LassiHeikkila/imu-mouse-hw/imu-mouse-3d-2.png

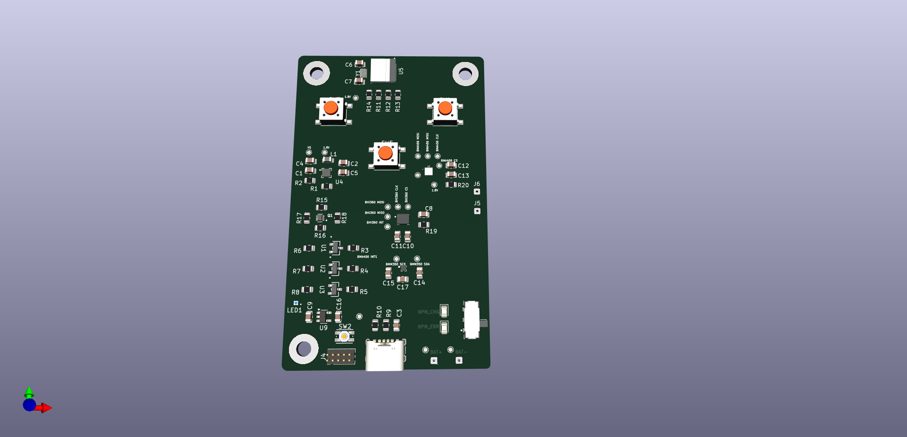
imu-mouse-3d-2.png
