LassiHeikkila/imu-mouse-hw/imu-mouse-3d-1.png

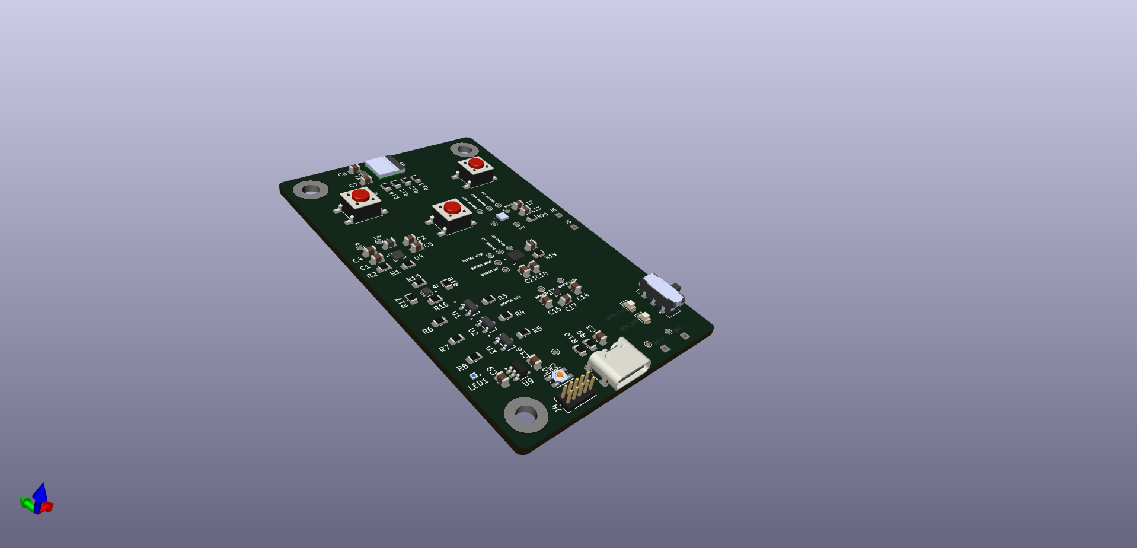
imu-mouse-3d-1.png
