LassiHeikkila/imu-mouse-hw/symbols/ANNA_B112_70B/ANNA-B112--3DModel-STEP-56544.STEP

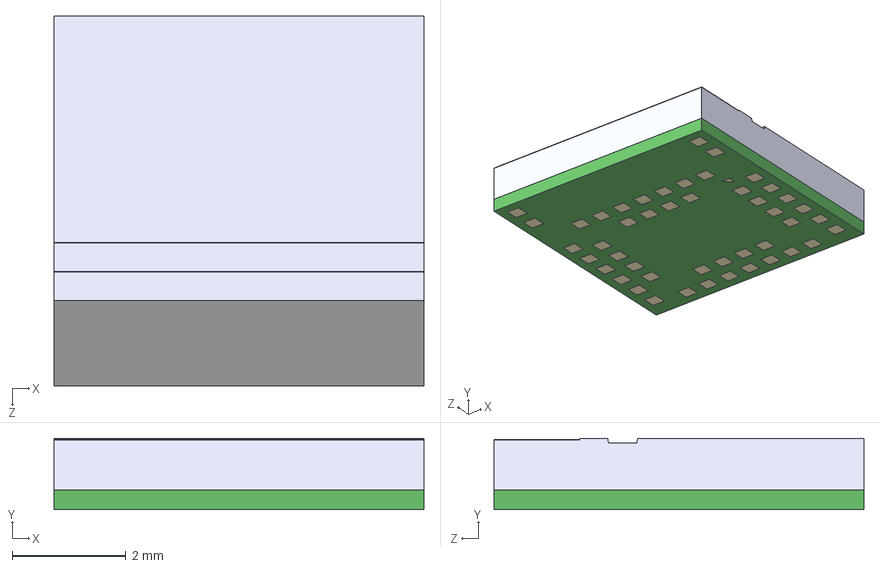
[picture p3: CAD file, 2024-06-25]
symbols/ANNA_B112_70B/ANNA-B112--3DModel-STEP-56544.STEP
6.50 x 1.25 x 6.50 mm
