LassiHeikkila/imu-mouse-hw/symbols/BHI360/LGA20_2p5X3X0p95_BOS.step

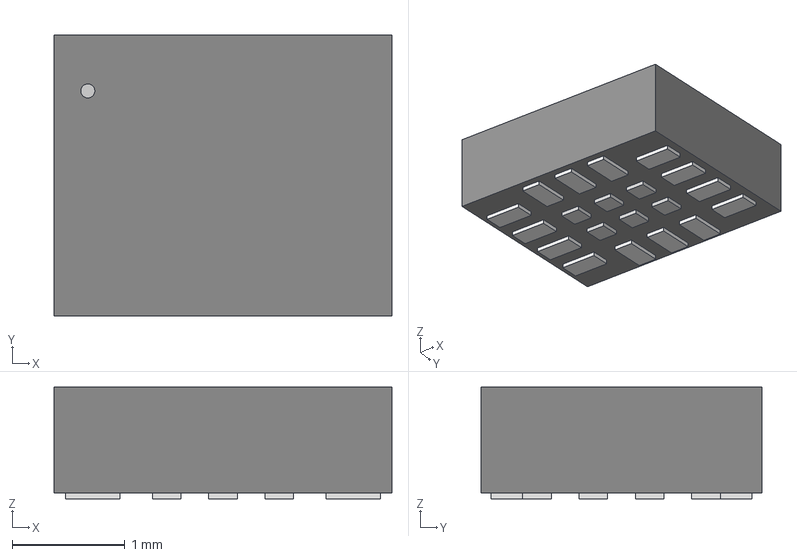
[picture p4: CAD file, 2024-06-25]
symbols/BHI360/LGA20_2p5X3X0p95_BOS.step
3.00 x 2.49 x 0.993 mm
