LassiHeikkila/imu-mouse-hw/symbols/BMA456/BMA456.step

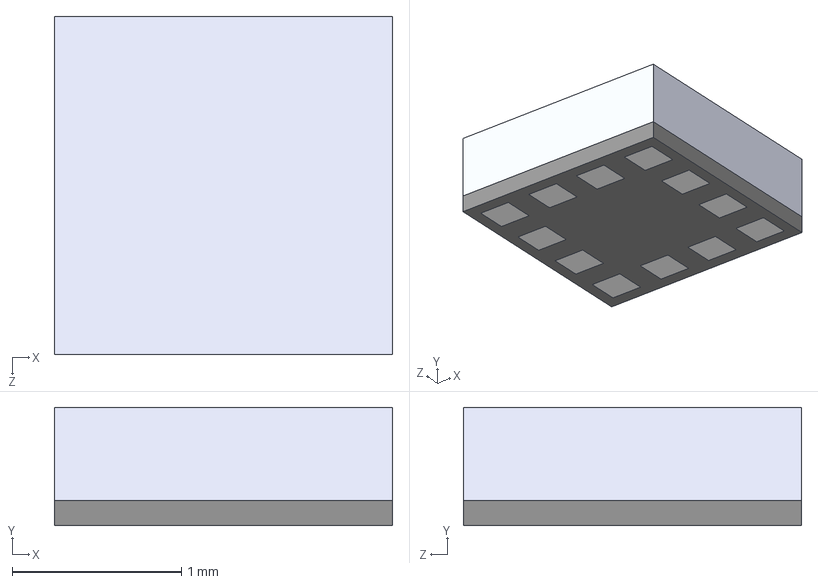
[picture p5: CAD file, 2024-06-25]
symbols/BMA456/BMA456.step
2.00 x 0.7 x 2.00 mm
