LassiHeikkila/imu-mouse-hw/symbols/BMM350/BGA9_BMM350_BOS.step

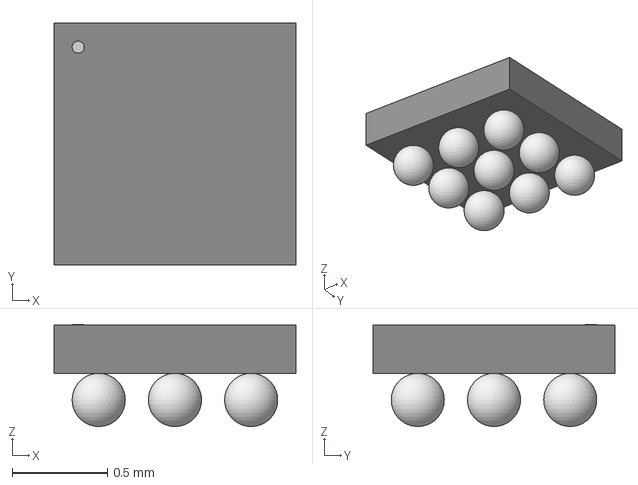
[picture p6: CAD file, 2024-06-25]
symbols/BMM350/BGA9_BMM350_BOS.step
1.27 x 1.27 x 0.536 mm
