LassiHeikkila/imu-mouse-hw/symbols/DMC2400UV-13/DMC2400UV-13.step

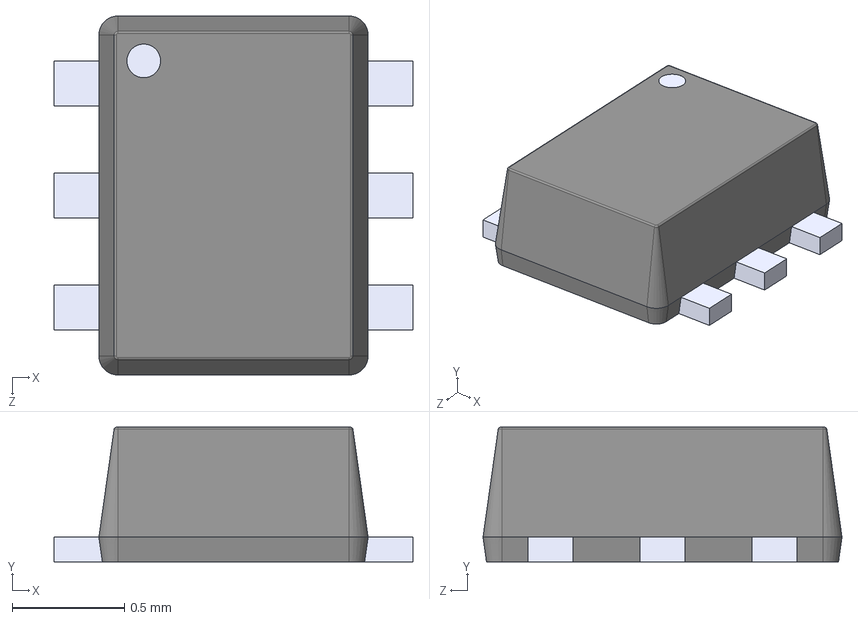
[picture p7: CAD file, 2024-06-25]
symbols/DMC2400UV-13/DMC2400UV-13.step
1.60 x 0.6 x 1.60 mm
