LassiHeikkila/imu-mouse-hw/symbols/FDV303N/FDV303N.STEP

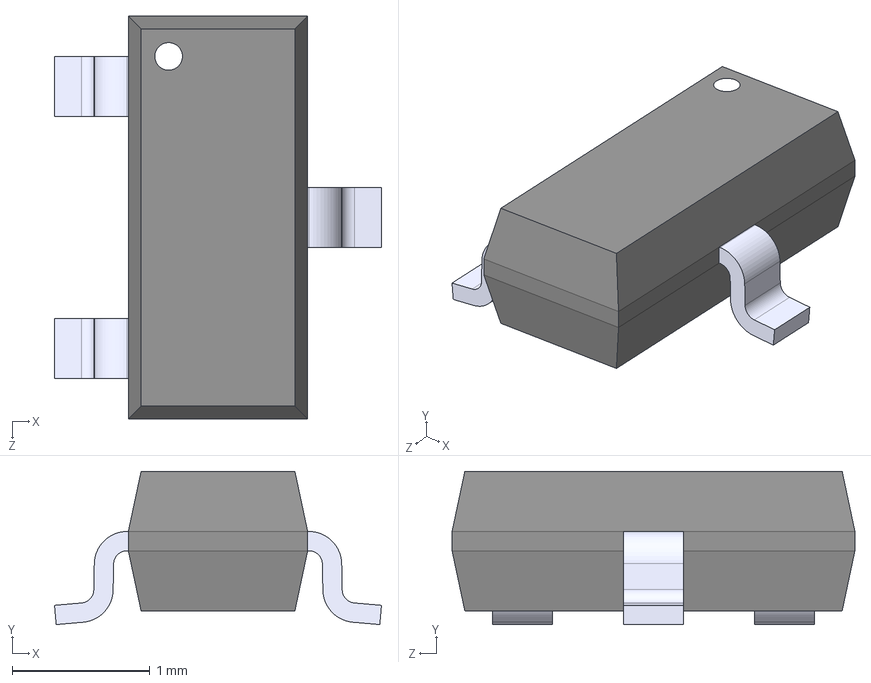
[picture p8: CAD file, 2024-06-25]
symbols/FDV303N/FDV303N.STEP
2.37 x 1.11 x 2.92 mm
