LassiHeikkila/imu-mouse-hw/symbols/NPM1100-CAAA-R7/NPM1100-CAAA-R7.step

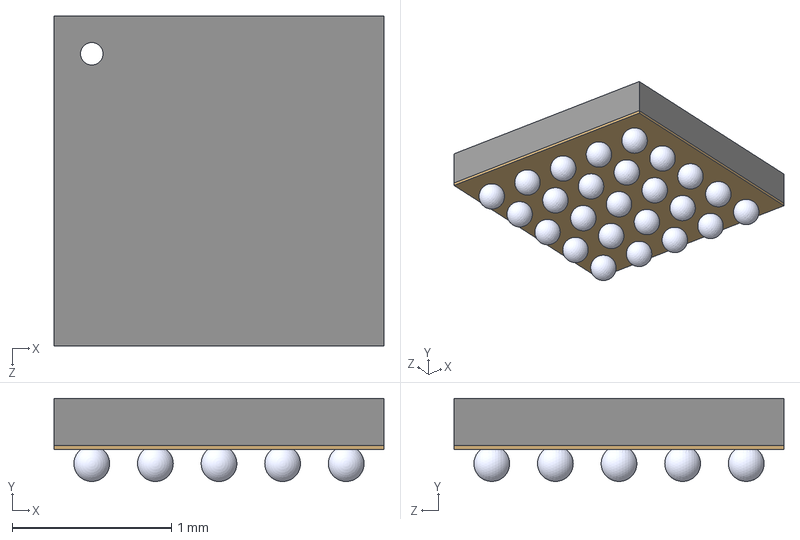
[picture p9: CAD file, 2024-06-25]
symbols/NPM1100-CAAA-R7/NPM1100-CAAA-R7.step
2.08 x 0.522 x 2.08 mm
