LassiHeikkila/imu-mouse-hw/symbols/PTS645SL43SMTR92LFS/TL3342F160QG_TR--3DModel-STEP-1.STEP

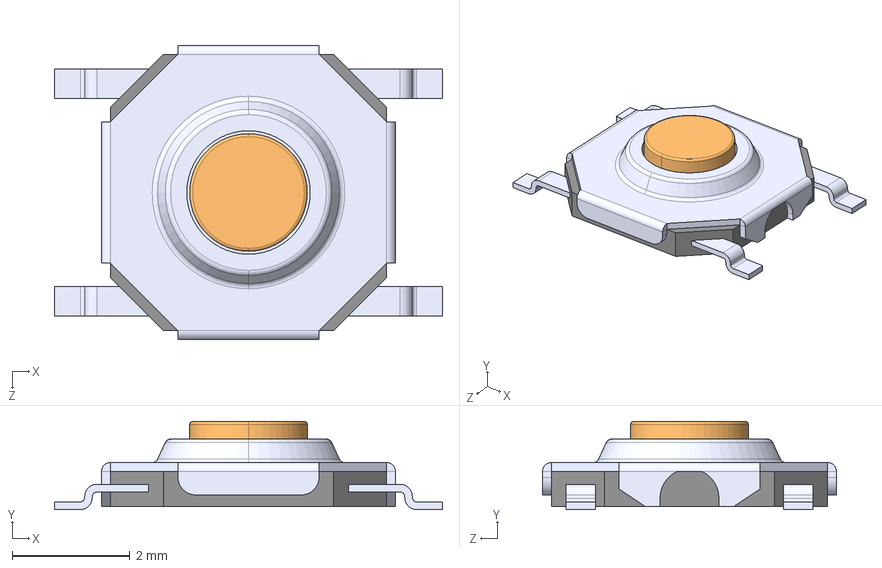
[picture p10: CAD file, 2024-06-25]
symbols/PTS645SL43SMTR92LFS/TL3342F160QG_TR--3DModel-STEP-1.STEP
6.60 x 1.50 x 5.00 mm
