LassiHeikkila/imu-mouse-hw/symbols/USB4125_GF_A/USB4125-GF-A_REVA2.step

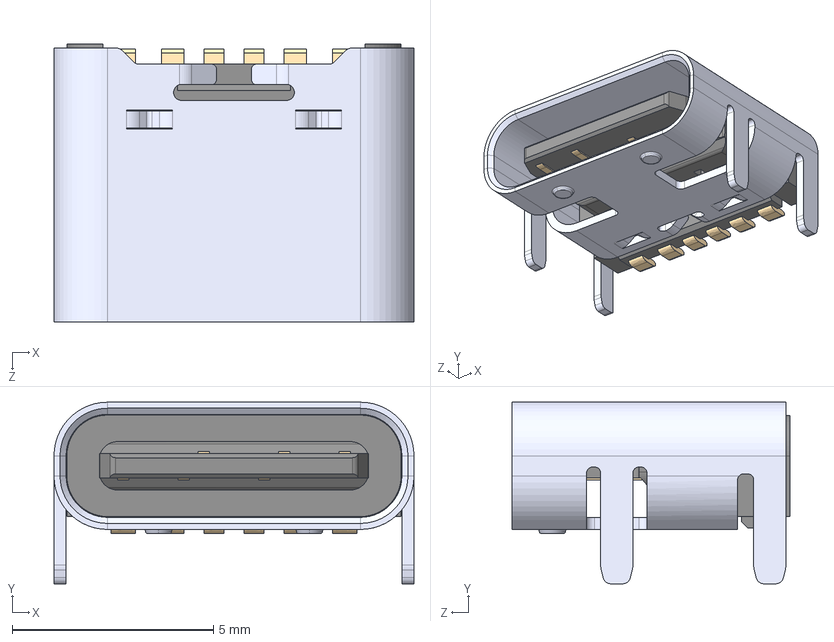
[picture p11: CAD file, 2024-06-25]
symbols/USB4125_GF_A/USB4125-GF-A_REVA2.step
8.94 x 4.51 x 6.90 mm
