LassiHeikkila/imu-mouse-hw/symbols/TPS22916BYFPR/TPS22916BYFPR.step

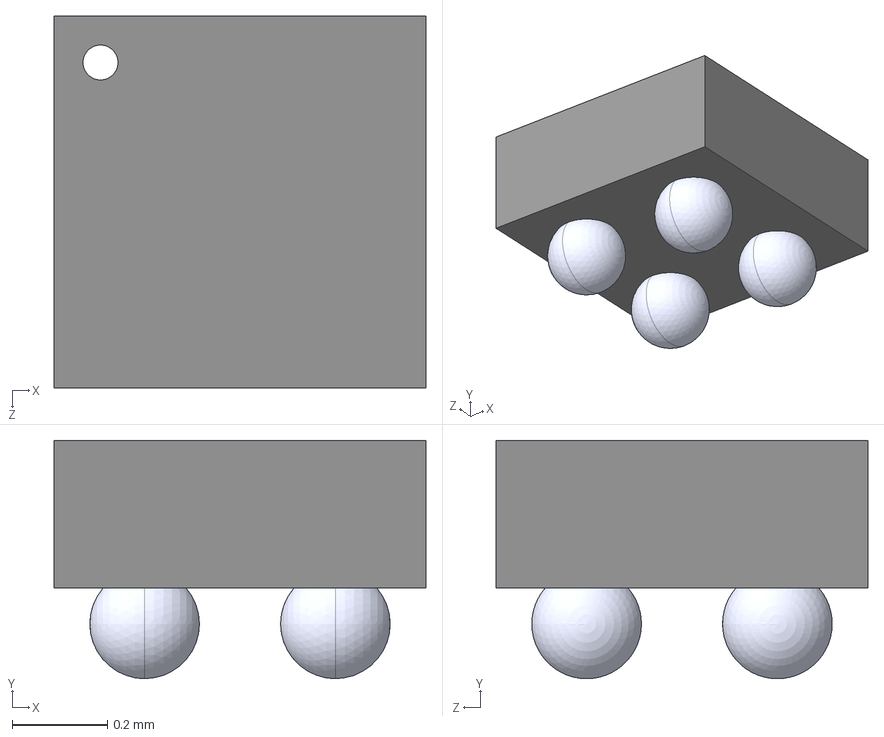
[picture p12: CAD file, 2024-06-25]
symbols/TPS22916BYFPR/TPS22916BYFPR.step
0.78 x 0.5 x 0.78 mm
