LassiHeikkila/imu-mouse-hw/symbols/JS202011JAQN (1)/JS202011JAQN.step

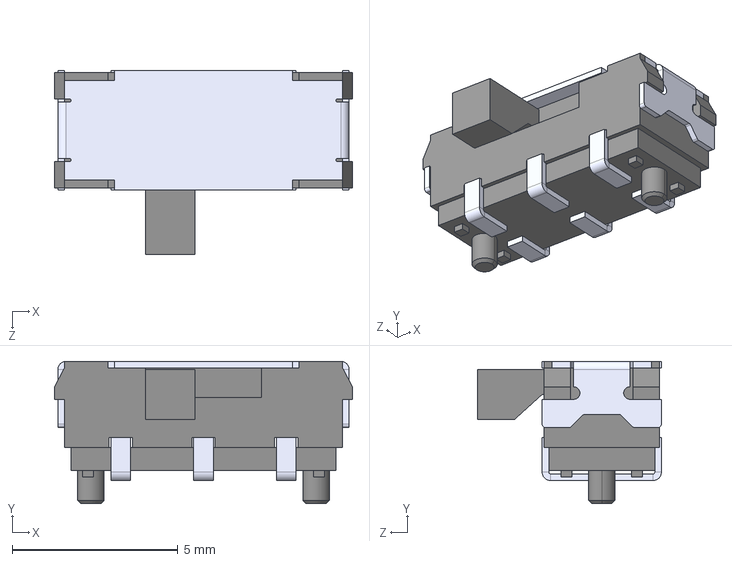
[picture p13: CAD file, 2024-06-25, an earlier design]
symbols/JS202011JAQN (1)/JS202011JAQN.step
9.00 x 4.30 x 5.55 mm
