LassiHeikkila/imu-mouse-hw/imu-mouse.kicad_pcb

## KiCad design imu-mouse.kicad_pcb (2024-06-25)

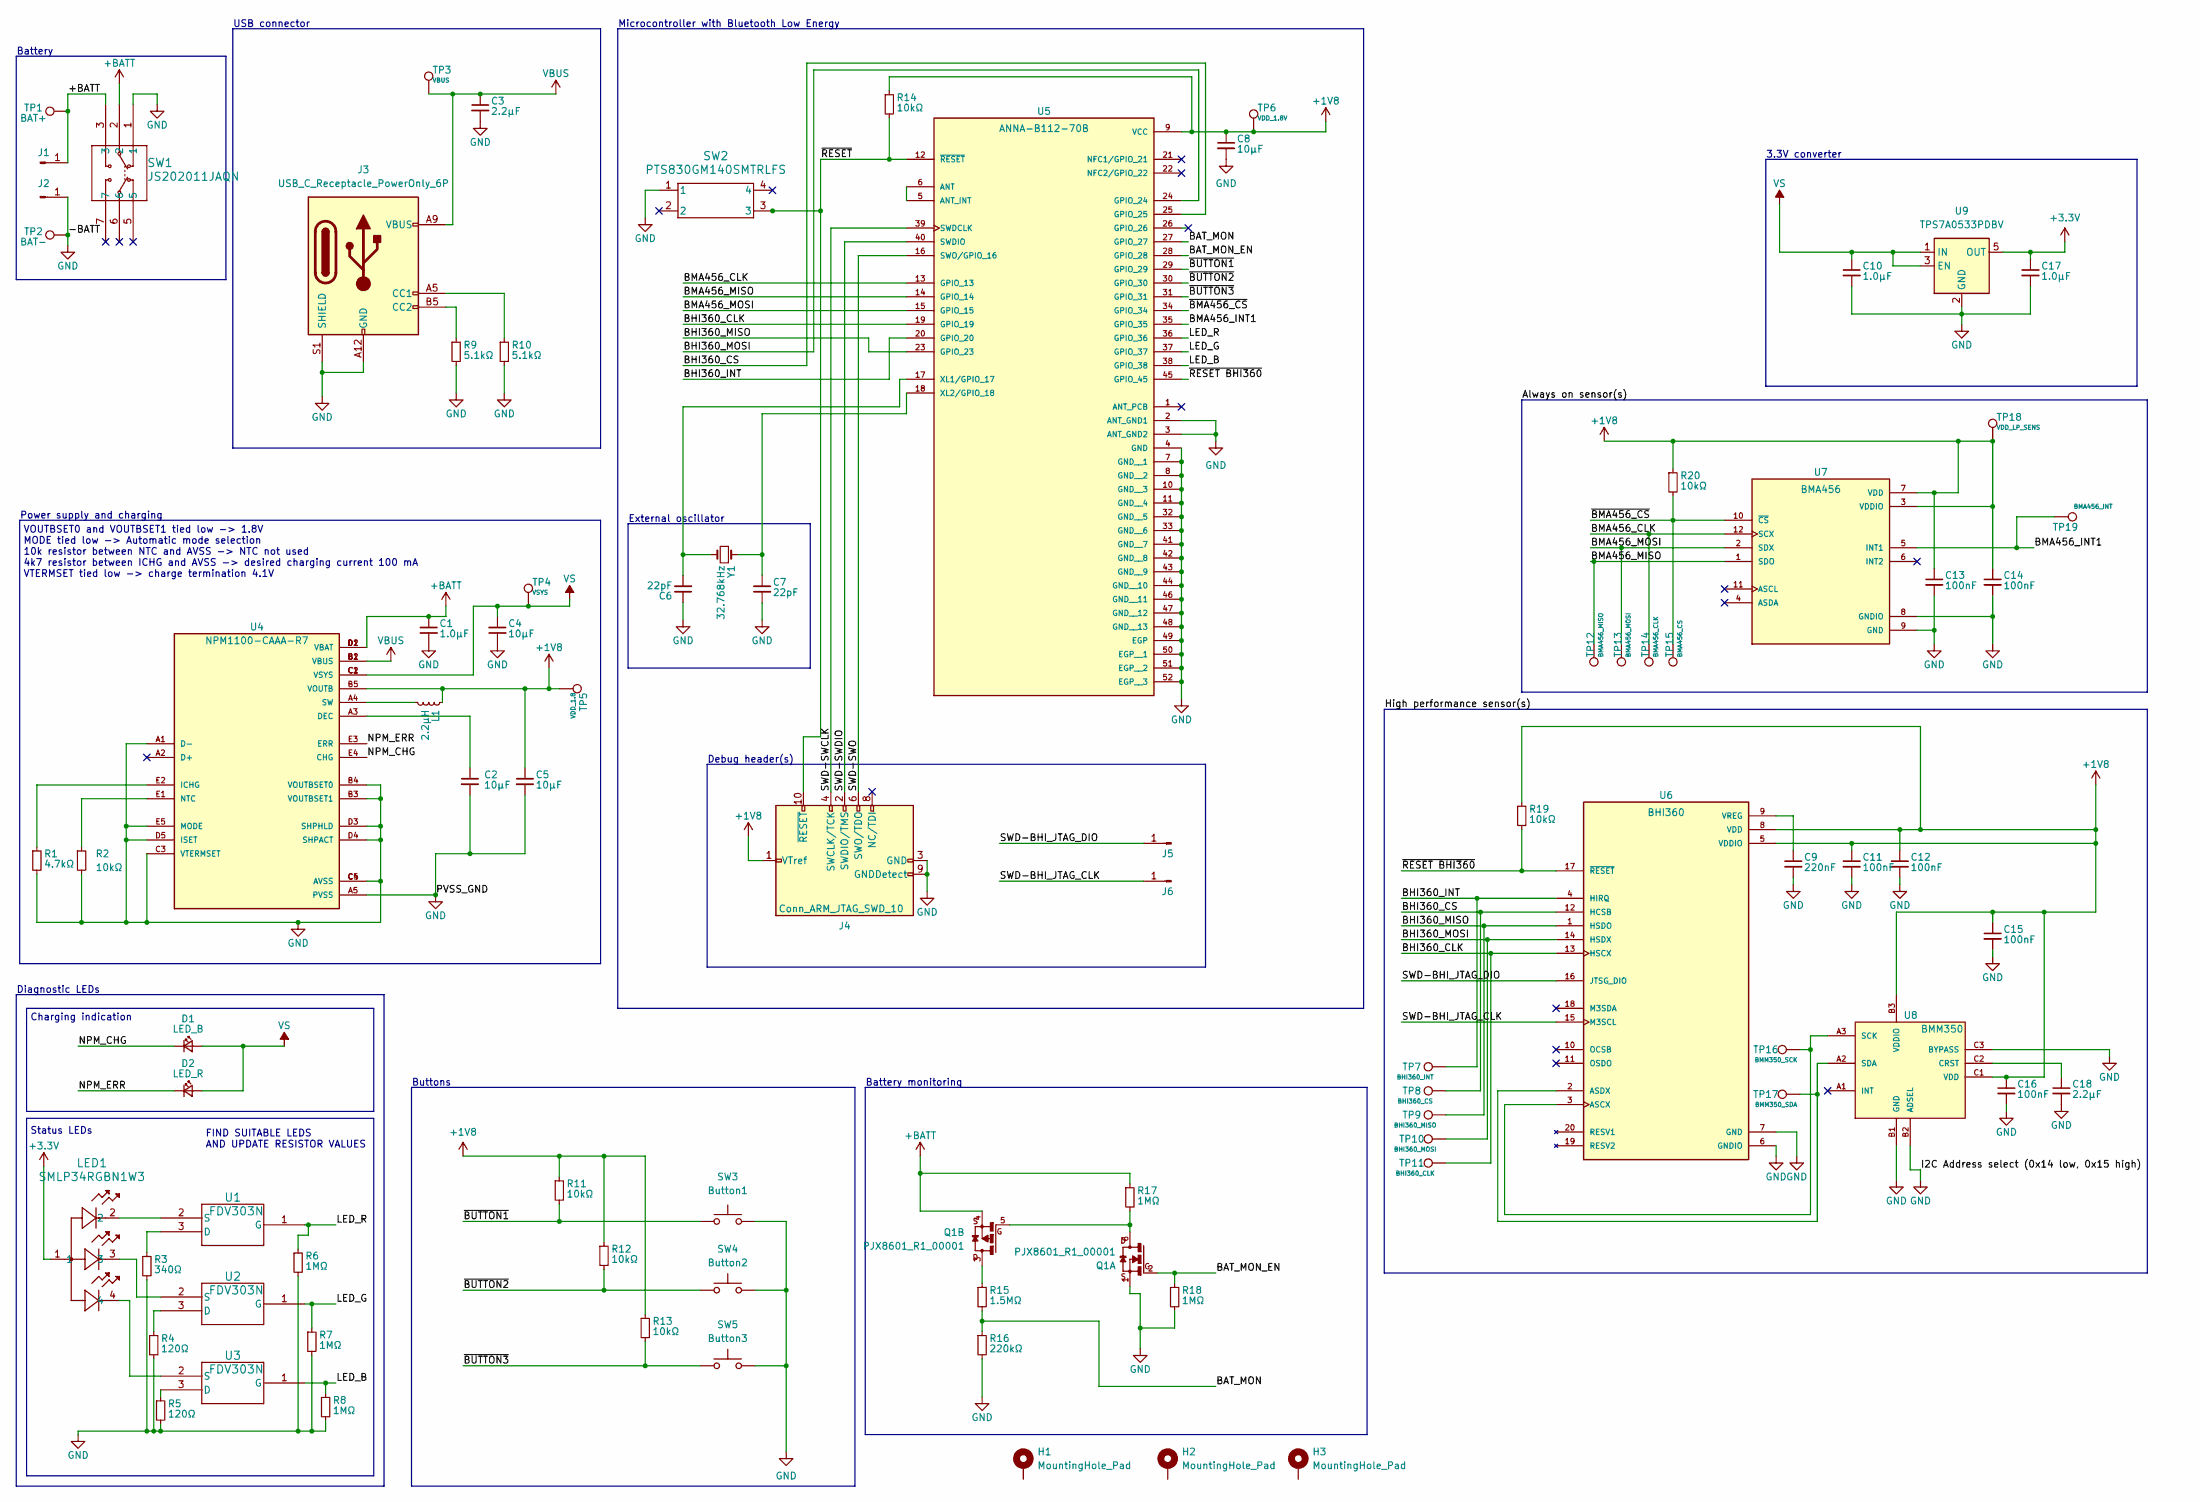
[picture p14: schematic imu-mouse.kicad_sch, imu-mouse board]

Parts:
C1, C10, C17: 1.0µF; C_0805_2012Metric; DigiKey_Part_Number CC0805KKX7R8BB105
C2, C4, C5, C8: 10µF; C_0805_2012Metric; DigiKey_Part_Number CC0805KKX7R6BB106
C3, C18: 2.2µF; C_0805_2012Metric; DigiKey_Part_Number CC0805KRX5R7BB225
C6, C7: 22pF; C_0805_2012Metric; DigiKey_Part_Number CC0805KKX7R6BB106
C9: 220nF; C_0805_2012Metric; DigiKey_Part_Number CC0805KRX7R8BB224
C11, C12, C13, C14, C15, C16: 100nF; C_0805_2012Metric; DigiKey_Part_Number CC0805KRX7R9BB104
D1: LED_B; LED_0805_2012Metric; DigiKey_Part_Number 150080BS75000
D2: LED_R; LED_0805_2012Metric; DigiKey_Part_Number 150080RS75000
H1, H2, H3: MountingHole_Pad; MountingHole_3.5mm_Pad
J1, J2, J5, J6: Conn_01x01_Pin; SolderWire-0.1sqmm_1x01_D0.4mm_OD1mm
J3: USB_C_Receptacle_PowerOnly_6P; USB_C_Receptacle_GCT_USB4125-xx-x_6P_TopMnt_Horizontal; DigiKey_Part_Number USB4125-GF-A
J4: Conn_ARM_JTAG_SWD_10; PinHeader_2x05_P1.27mm_Vertical; DigiKey_Part_Number FTSH-105-01-L-DV-007-K
L1: 2.2µH; L_0805_2012Metric; DigiKey_Part_Number dfe201210u-2r2m-p2
LED1: SMLP34RGBN1W3; SMLP34_ROM; DigiKey_Part_Number SMLP34RGBN1W3
Q1: PJX8601_R1_00001; SOT50P160X60-6N; DigiKey_Part_Number PJX8601-R1-00001
R1: 4.7kΩ; R_0805_2012Metric; DigiKey_Part_Number RC0805FR-071K5L
R2, R11, R12, R13, R14, R19, R20: 10kΩ; R_0805_2012Metric; DigiKey_Part_Number RT0805FRE0710KL
R3: 340Ω; R_0805_2012Metric; DigiKey_Part_Number RC0805FR-07330RL
R4, R5: 120Ω; R_0805_2012Metric; DigiKey_Part_Number RT0805FRE07120RL
R6, R7, R8, R17, R18: 1MΩ; R_0805_2012Metric; DigiKey_Part_Number RC0805FR-071ML
R9, R10: 5.1kΩ; R_0805_2012Metric; DigiKey_Part_Number RC0805JR-075K1L
R15: 1.5MΩ; R_0805_2012Metric; DigiKey_Part_Number RT0805FRE071M5L
R16: 220kΩ; R_0805_2012Metric; DigiKey_Part_Number RT0805FRE07220KL
SW1: JS202011JAQN; DigiKey_Part_Number JS202011JAQN
SW2: PTS830GM140SMTRLFS; SWITCH_0SMTRLFS; DigiKey_Part_Number PTS830GM140-SMTR-LFS
SW3: Button1; SW_SPST_PTS645; DigiKey_Part_Number PTS645SL43SMTR92-LFS
SW4: Button2; SW_SPST_PTS645; DigiKey_Part_Number PTS645SL43SMTR92-LFS
SW5: Button3; SW_SPST_PTS645; DigiKey_Part_Number PTS645SL43SMTR92-LFS
TP1: BAT+; TestPoint_Pad_D1.0mm
TP2: BAT-; TestPoint_Pad_D1.0mm
TP3: VBUS; TestPoint_Pad_D1.0mm
TP4: VSYS; TestPoint_Pad_D1.0mm
TP5: VDD_1.8; TestPoint_Pad_D1.0mm
TP6: VDD_1.8V; TestPoint_Pad_D1.0mm
TP7: BHI360_INT; TestPoint_Pad_D1.0mm
TP8: BHI360_CS; TestPoint_Pad_D1.0mm
TP9: BHI360_MISO; TestPoint_Pad_D1.0mm
TP10: BHI360_MOSI; TestPoint_Pad_D1.0mm
TP11: BHI360_CLK; TestPoint_Pad_D1.0mm
TP12: BMA456_MISO; TestPoint_Pad_D1.0mm
TP13: BMA456_MOSI; TestPoint_Pad_D1.0mm
TP14: BMA456_CLK; TestPoint_Pad_D1.0mm
TP15: BMA456_CS; TestPoint_Pad_D1.0mm
TP16: BMM350_SCK; TestPoint_Pad_D1.0mm
TP17: BMM350_SDA; TestPoint_Pad_D1.0mm
TP18: VDD_LP_SENS; TestPoint_Pad_D1.0mm
TP19: BMA456_INT; TestPoint_Pad_D1.0mm
U1, U2, U3: FDV303N; SOT-23-3L_FAS; DigiKey_Part_Number FDV303N
U4: NPM1100-CAAA-R7; BGA25C40P5X5_207X207X52N; DigiKey_Part_Number npm1100-caab-r
U5: ANNA-B112-70B; XCVR_ANNA-B112-70B; DigiKey_Part_Number anna-b112-70b
U6: BHI360; XDCR_BHI360; DigiKey_Part_Number bhi360
U7: BMA456; XDCR_BMA456; DigiKey_Part_Number bma456
U8: BMM350; BGA9C40P3X3_128X128X50; DigiKey_Part_Number BMM350
U9: TPS7A0533PDBV; SOT-23-5; DigiKey_Part_Number TPS7A0533PDBVR
Y1: 32.768kHz; Crystal_SMD_2012-2Pin_2.0x1.2mm; DigiKey_Part_Number FC-12M-32-7680KD-A0

Connections:
+1V8: C5.1, C8.1, C11.1, C12.1, C13.1, C14.1, C15.1, C16.1, J4.1 (VTref), L1.1, R11.1, R12.1, R13.1, R14.1, R19.1, R20.1, TP5.1, TP6.1, TP18.1, U4.B5 (VOUTB), U5.9 (VCC), U6.5 (VDDIO), U6.8 (VDD), U7.3 (VDDIO), U7.7 (VDD), U8.B3 (VDDIO), U8.C1 (VDD); also elsewhere on the board
+3.3V: C17.1, LED1.1, U9.5 (OUT)
+BATT: C1.1, J1.1, Q1.4, R17.1, SW1.2, SW1.3, TP1.1, U4.D1 (VBAT), U4.D2 (VBAT)
/BAT_MON: R15.2, R16.1, U5.27 (GPIO_27); also elsewhere on the board
/BAT_MON_EN: Q1.2, R18.1, U5.28 (GPIO_28); also elsewhere on the board
/BHI360_CLK: TP11.1, U5.19 (GPIO_19), U6.13 (HSCX); also elsewhere on the board
/BHI360_CS: TP8.1, U5.25 (GPIO_25), U6.12 (HCSB); also elsewhere on the board
/BHI360_INT: TP7.1, U5.20 (GPIO_20), U6.4 (HIRQ); also elsewhere on the board
/BHI360_MISO: TP9.1, U5.23 (GPIO_23), U6.1 (HSDO); also elsewhere on the board
/BHI360_MOSI: TP10.1, U5.24 (GPIO_24), U6.14 (HSDX); also elsewhere on the board
/BMA456_CLK: TP14.1, U5.13 (GPIO_13), U7.12 (SCX); also elsewhere on the board
/BMA456_INT1: TP19.1, U5.35 (GPIO_35), U7.5 (INT1); also elsewhere on the board
/BMA456_MISO: TP12.1, U5.14 (GPIO_14), U7.1 (SDO); also elsewhere on the board
/BMA456_MOSI: TP13.1, U5.15 (GPIO_15), U7.2 (SDX); also elsewhere on the board
/LED_B: R8.1, U3.1 (G), U5.38 (GPIO_38); also elsewhere on the board
/LED_G: R7.1, U2.1 (G), U5.37 (GPIO_37); also elsewhere on the board
/LED_R: R6.1, U1.1 (G), U5.36 (GPIO_36); also elsewhere on the board
/NPM_CHG: D1.1 (K), U4.E4 (CHG)
/NPM_ERR: D2.1 (K), U4.E3 (ERR)
/SWD-BHI_JTAG_CLK: J6.1, U6.15 (M3SCL)
/SWD-BHI_JTAG_DIO: J5.1, U6.16 (JTSG_DIO)
/SWD-SWCLK: J4.4 (SWCLK/TCK), U5.39 (SWDCLK); also elsewhere on the board
/SWD-SWDIO: J4.2 (SWDIO/TMS), U5.40 (SWDIO); also elsewhere on the board
/SWD-SWO: J4.6 (SWO/TDO), U5.16 (SWO/GPIO_16); also elsewhere on the board
/~BMA456_CS: R20.2, TP15.1, U5.34 (GPIO_34), U7.10 (~CS); also elsewhere on the board
/~BUTTON1: R11.2, SW3.1, U5.29 (GPIO_29); also elsewhere on the board
/~BUTTON2: R12.2, SW4.1, U5.30 (GPIO_30); also elsewhere on the board
/~BUTTON3: R13.2, SW5.1, U5.31 (GPIO_31); also elsewhere on the board
/~RESET BHI360: R19.2, U5.45 (GPIO_45), U6.17 (~RESET); also elsewhere on the board
/~RESET: J4.10 (~RESET), R14.2, SW2.3, U5.12 (~RESET); also elsewhere on the board
GND: C1.2, C2.2, C3.2, C4.2, C5.2, C6.1, C7.2, C8.2, C9.2, C10.2, C11.2, C12.2, C13.2, C14.2, C15.2, C16.2, C17.2, C18.2, J2.1, J3.A12 (GND), J3.B12 (GND), J3.S1 (SHIELD), J4.3 (GND), J4.5 (GND), J4.9 (GNDDetect), Q1.1, R1.2, R2.2, R3.2, R4.2, R5.2, R6.2, R7.2, R8.2, R9.2, R10.2, R16.2, R18.2, SW1.1, SW2.1, SW3.2, SW4.2, SW5.2, TP2.1, U4.A1 (D-), U4.A5 (PVSS), U4.B3 (VOUTBSET1), U4.B4 (VOUTBSET0), U4.C3 (VTERMSET), U4.C4 (AVSS), U4.C5 (AVSS), U4.D3 (SHPHLD), U4.D4 (SHPACT), U4.D5 (ISET), U4.E5 (MODE), U5.2 (ANT_GND1), U5.3 (ANT_GND2), U5.4 (GND), U5.7 (GND__1), U5.8 (GND__2), U5.10 (GND__3), U5.11 (GND__4), U5.32 (GND__5), U5.33 (GND__6), U5.41 (GND__7), U5.42 (GND__8), U5.43 (GND__9), U5.44 (GND__10), U5.46 (GND__11), U5.47 (GND__12), U5.48 (GND__13), U5.49 (EGP), U5.50 (EGP__1), U5.51 (EGP__2), U5.52 (EGP__3), U6.6 (GNDIO), U6.7 (GND), U7.8 (GNDIO), U7.9 (GND), U8.B1 (GND), U8.B2 (ADSEL), U8.C3 (BYPASS), U9.2 (GND); also elsewhere on the board
unnamed: J3.A5 (CC1), R10.1
unnamed: J3.B5 (CC2), R9.1
unnamed: Q1.3, R15.1
unnamed: Q1.5, Q1.6, R17.2
unnamed: R3.1, U1.3 (D)
unnamed: LED1.2, U1.2 (S)
unnamed: R4.1, U2.3 (D)
unnamed: LED1.3, U2.2 (S)
unnamed: R5.1, U3.3 (D)
unnamed: LED1.4, U3.2 (S)
unnamed: C2.1, U4.A3 (DEC)
unnamed: R1.1, U4.E2 (ICHG)
unnamed: R2.1, U4.E1 (NTC)
unnamed: L1.2, U4.A4 (SW)
unnamed: U5.5 (ANT_INT), U5.6 (ANT)
unnamed 47: C6.2, U5.17 (XL1/GPIO_17), Y1.2; also elsewhere on the board
unnamed 48: C7.1, U5.18 (XL2/GPIO_18), Y1.1; also elsewhere on the board
unnamed: TP16.1, U6.3 (ASCX), U8.A3 (SCK)
unnamed: TP17.1, U6.2 (ASDX), U8.A2 (SDA)
unnamed: C9.1, U6.9 (VREG)
unnamed: C18.1, U8.C2 (CRST)
VBUS: C3.1, J3.A9 (VBUS), J3.B9 (VBUS), TP3.1, U4.B1 (VBUS), U4.B2 (VBUS)
VS: C4.1, C10.1, D1.2 (A), D2.2 (A), TP4.1, U4.C1 (VSYS), U4.C2 (VSYS), U9.1 (IN), U9.3 (EN)

Notes on the sheet:
USB connector
Microcontroller with Bluetooth Low Energy
Power supply and charging
External oscillator
VOUTBSET0 and VOUTBSET1 tied low -> 1.8V MODE tied low -> Automatic mode selection 10k resistor between NTC and AVSS -> NTC not used 4k7 resistor between ICHG and AVSS -> desired charging current 100 mA VTERMSET tied low -> charge termination 4.1V
FIND SUITABLE LEDS AND UPDATE RESISTOR VALUES
Diagnostic LEDs
Debug header(s)
Buttons
Battery monitoring
Status LEDs
Charging indication
Battery
3.3V converter

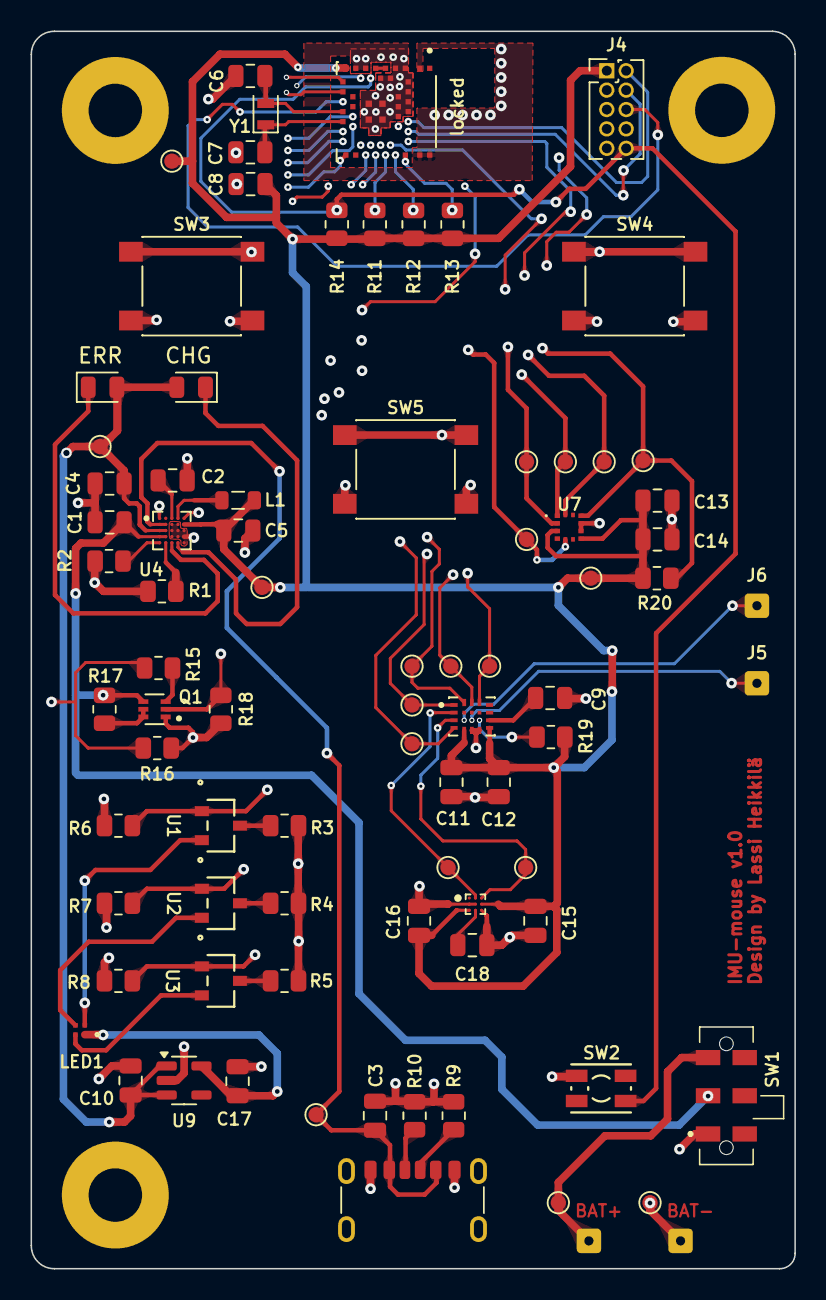
[picture p15: board imu-mouse.kicad_pcb from above]

Board: 4 copper layers, 50.0 x 81.0 mm, 86 parts (0 on the bottom side), 54 nets.

Other parts of the board:
locked: ANNA-B112-70B; XCVR_ANNA-B112-70B

Their connections:
+1V8: locked.9 (VCC); also elsewhere on the board
/BAT_MON: locked.27 (GPIO_27); also elsewhere on the board
/BAT_MON_EN: locked.28 (GPIO_28); also elsewhere on the board
/BHI360_CLK: locked.19 (GPIO_19); also elsewhere on the board
/BHI360_CS: locked.25 (GPIO_25); also elsewhere on the board
/BHI360_INT: locked.20 (GPIO_20); also elsewhere on the board
/BHI360_MISO: locked.23 (GPIO_23); also elsewhere on the board
/BHI360_MOSI: locked.24 (GPIO_24); also elsewhere on the board
/BMA456_CLK: locked.13 (GPIO_13); also elsewhere on the board
/BMA456_INT1: locked.35 (GPIO_35); also elsewhere on the board
/BMA456_MISO: locked.14 (GPIO_14); also elsewhere on the board
/BMA456_MOSI: locked.15 (GPIO_15); also elsewhere on the board
/LED_B: locked.38 (GPIO_38); also elsewhere on the board
/LED_G: locked.37 (GPIO_37); also elsewhere on the board
/LED_R: locked.36 (GPIO_36); also elsewhere on the board
/SWD-SWCLK: locked.39 (SWDCLK); also elsewhere on the board
/SWD-SWDIO: locked.40 (SWDIO); also elsewhere on the board
/SWD-SWO: locked.16 (SWO/GPIO_16); also elsewhere on the board
/~BMA456_CS: locked.34 (GPIO_34); also elsewhere on the board
/~BUTTON1: locked.29 (GPIO_29); also elsewhere on the board
/~BUTTON2: locked.30 (GPIO_30); also elsewhere on the board
/~BUTTON3: locked.31 (GPIO_31); also elsewhere on the board
/~RESET BHI360: locked.45 (GPIO_45); also elsewhere on the board
/~RESET: locked.12 (~RESET); also elsewhere on the board
GND: locked.2 (ANT_GND1), locked.3 (ANT_GND2), locked.4 (GND), locked.7 (GND__1), locked.8 (GND__2), locked.10 (GND__3), locked.11 (GND__4), locked.32 (GND__5), locked.33 (GND__6), locked.41 (GND__7), locked.42 (GND__8), locked.43 (GND__9), locked.44 (GND__10), locked.46 (GND__11), locked.47 (GND__12), locked.48 (GND__13), locked.49 (EGP), locked.50 (EGP__1), locked.51 (EGP__2), locked.52 (EGP__3); also elsewhere on the board
unnamed: locked.5 (ANT_INT), locked.6 (ANT)
unnamed 47: locked.17 (XL1/GPIO_17); also elsewhere on the board
unnamed 48: locked.18 (XL2/GPIO_18); also elsewhere on the board
